baramsel/vhdci_to_8fei4_rj45/README.md

# VHDCI to 8 FE-I4 RJ45
Simple adapter board to connect to 8 FE-I4 chips via RJ45 connectors.
