baramsel/vhdci_to_8fei4_rj45/(commit log)

2017-05-09 add Levelshifter hierarchical sheet
    [LVDSredriver.sch, Levelshifter.sch]
2017-05-09 Resize Levelshifter sheet. Create 3
    [vhdci_fei4_rj45.sch]
2017-05-10 Resize connector pins 0.65/0.95mm
    [vhdci_fei4_rj45.kicad_pcb]
2017-05-11 Route VHDCI to U2, U3, U6
    [vhdci_fei4_rj45.kicad_pcb]
2017-05-11 Route vhdci to U4, U5, U7
    [vhdci_fei4_rj45.kicad_pcb]
2017-05-11 Route data to RJ45s
    [vhdci_fei4_rj45.kicad_pcb]
2017-05-14 Route power, reroute data signals to top layer
    [LVDSredriver.sch, Levelshifter.sch, vhdci_fei4_rj45.kicad_pcb, vhdci_fei4_rj45.sch]
2017-05-14 Complete routing of U2, U3
    [vhdci_fei4_rj45.kicad_pcb]
2017-05-14 Route U6
    [vhdci_fei4_rj45.kicad_pcb]
2017-05-15 Route U6, U4, U5
    [LVDSredriver.sch, Levelshifter.sch, vhdci_fei4_rj45.kicad_pcb, vhdci_fei4_rj45.sch]
2017-05-15 Clean schematic, route U's
    [vhdci_fei4_rj45.kicad_pcb]
2017-05-15 Route 2 level shifters
    [LVDSredriver.sch, Levelshifter.sch, vhdci_fei4_rj45.kicad_pcb, vhdci_fei4_rj45.sch]
2017-05-16 Route level shifters, usb
    [vhdci_fei4_rj45.kicad_pcb]
